BootMerc/AI-finger-Oximeter/output/training_report.png

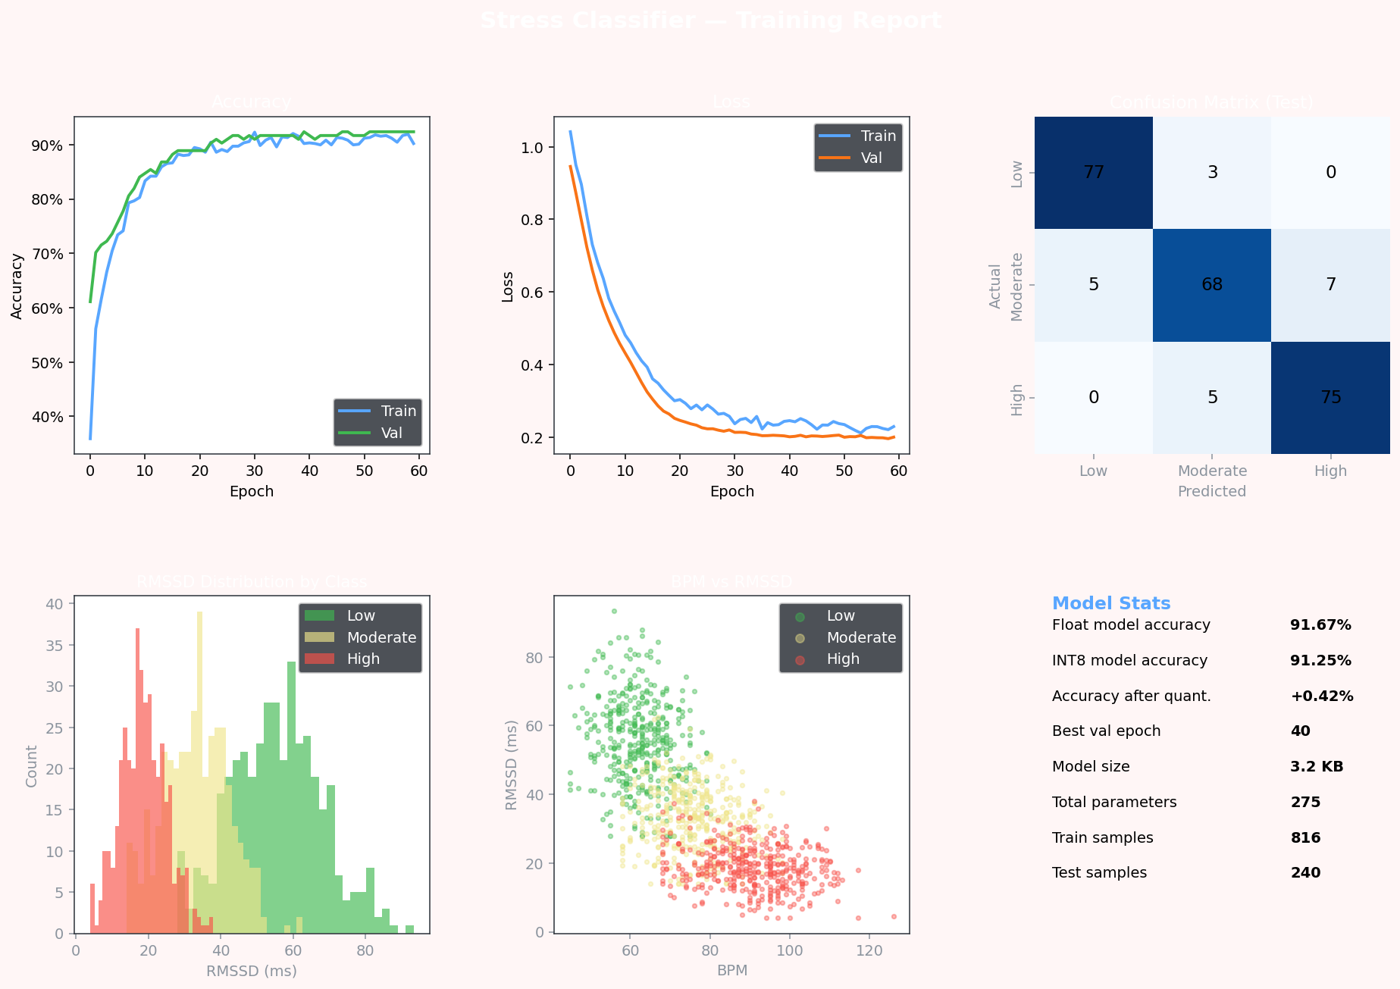
output/training_report.png
