BootMerc/AI-finger-Oximeter/PCB_PCB_ESP-32-S3-N16R8_2026-05-13 (1).pdf

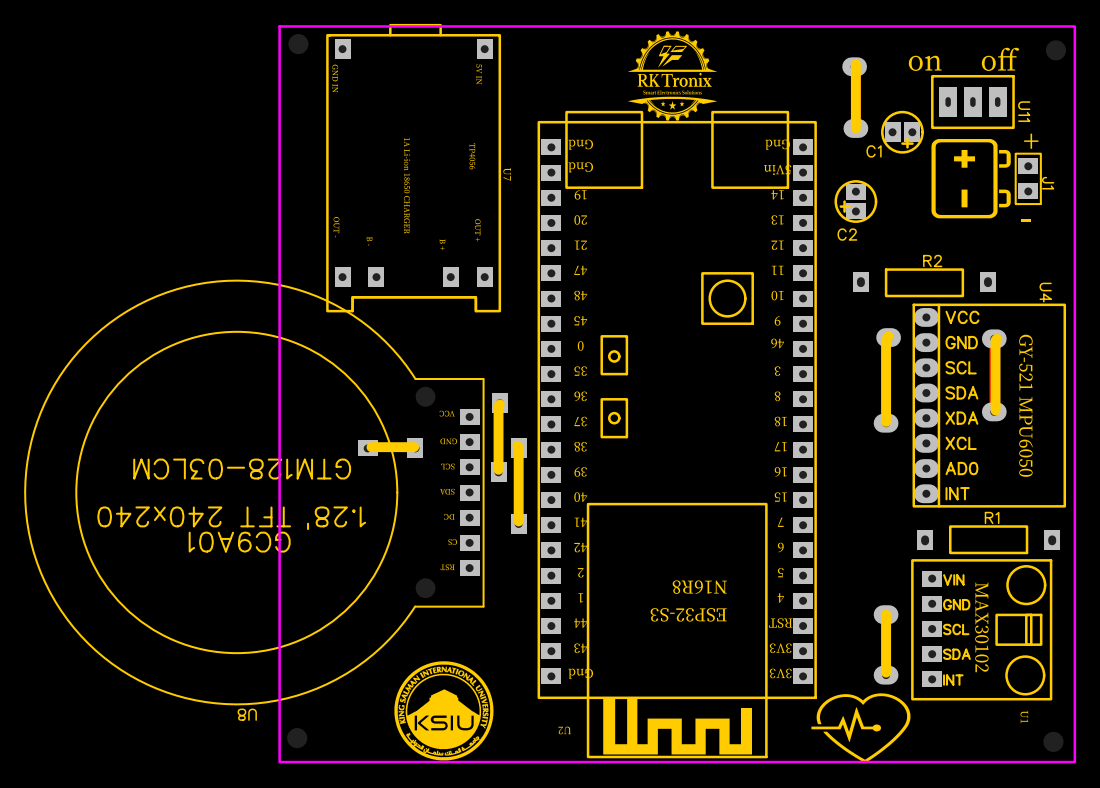
[picture p2: page 1]
