BootMerc/AI-finger-Oximeter/(commit log)

2026-07-01 stress labels
    [my_data.csv]
2026-07-01 PCB overlay
2026-07-01 Update README to remove unnecessary sections
    Removed sections on Repository Structure, Bill of Materials, and Acknowledgments from README.
