BootMerc/AI-finger-Oximeter/(notices)

Notices in the files:
README.md:
License: MIT
